kiu/flame/README

flame m0dul

kiu@gmx.net
GPL/CC-BY-3.0
https://github.com/kiu/flame
