kiu/flame/hardware/pcb/flame-rev-a-gerber.pdf

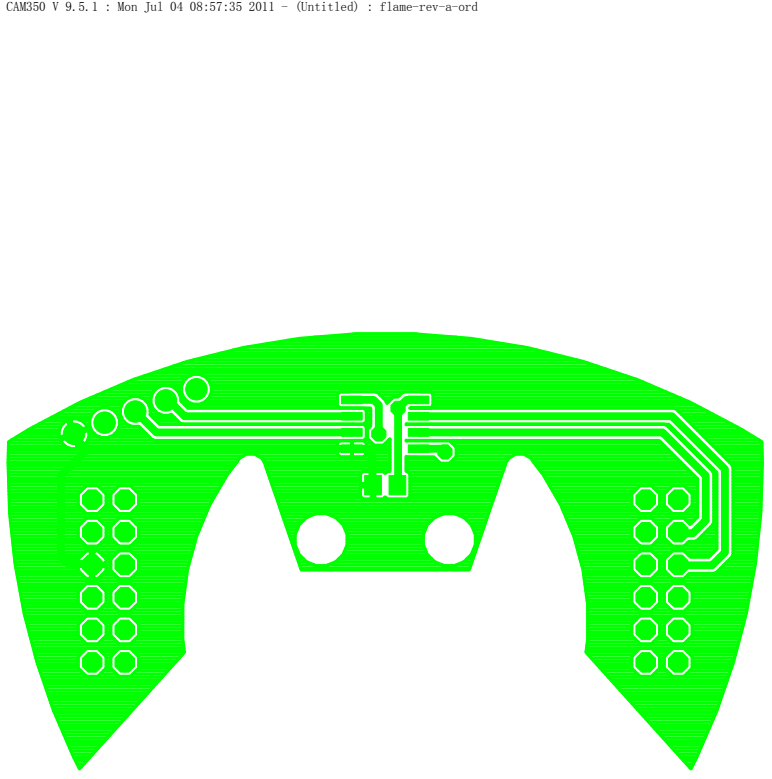
[picture p3: page 1]

CAM350 V 9.5.1 : Mon Jul 04 08:57:35 2011 - (Untitled) : flame-rev-a-ord

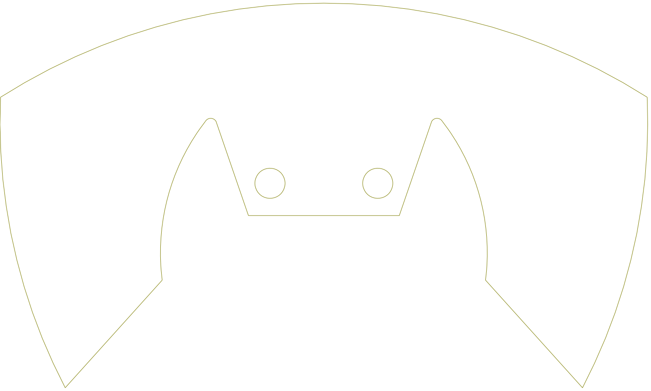
[picture p4: figure]

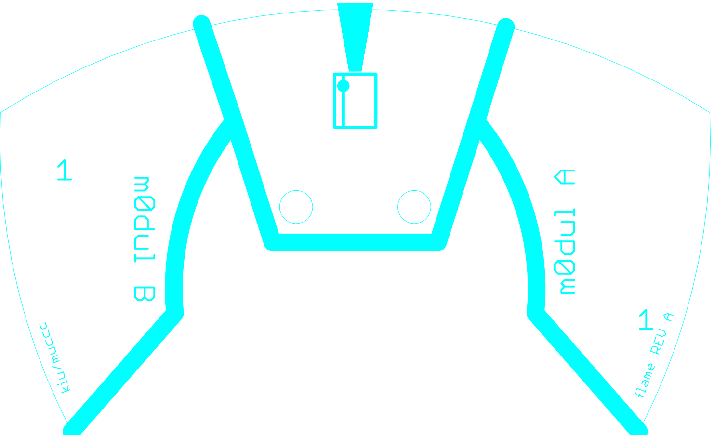
[picture p5: figure]
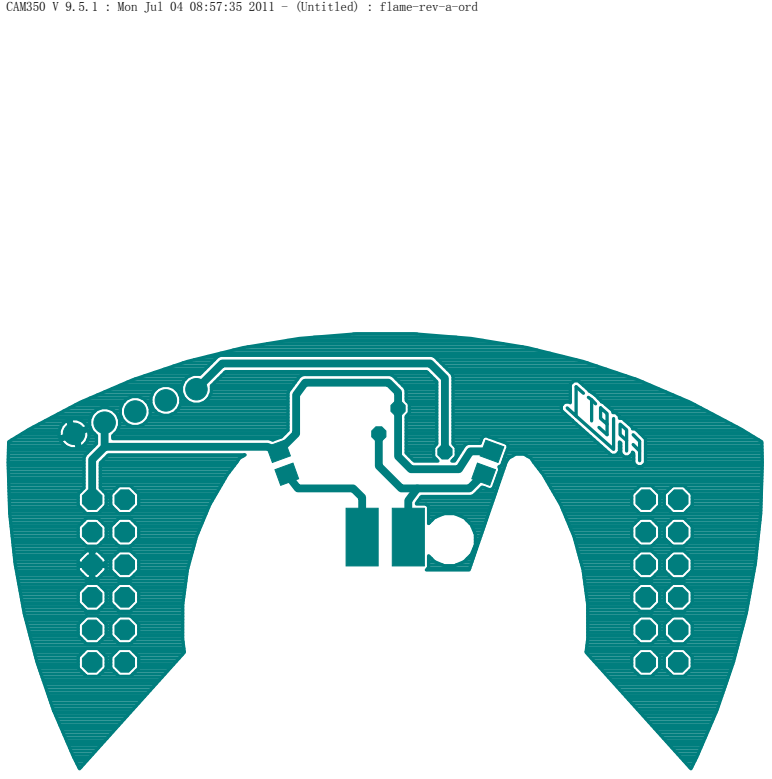
[picture p6: page 4]

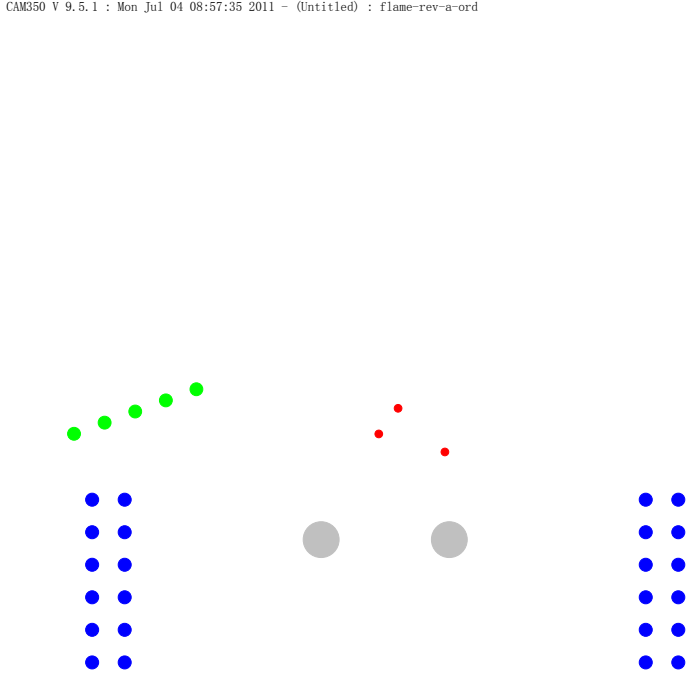
[picture p7: page 7]
