kiu/flame/hardware/pcb/flame-rev-a-brd-bottom.png

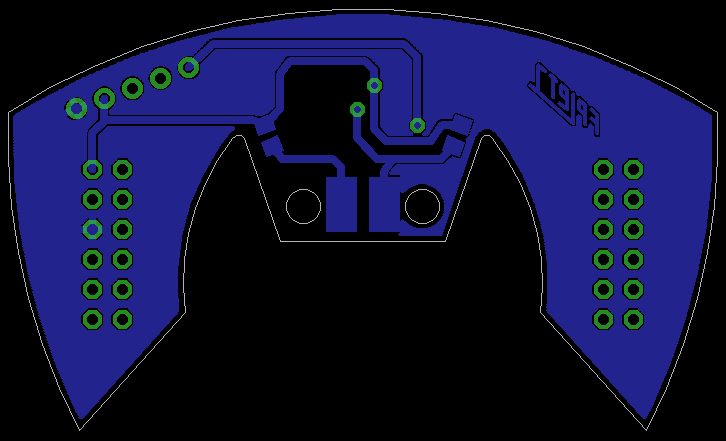
hardware/pcb/flame-rev-a-brd-bottom.png
