kiu/flame/hardware/pcb/flame-rev-a-brd-top.png

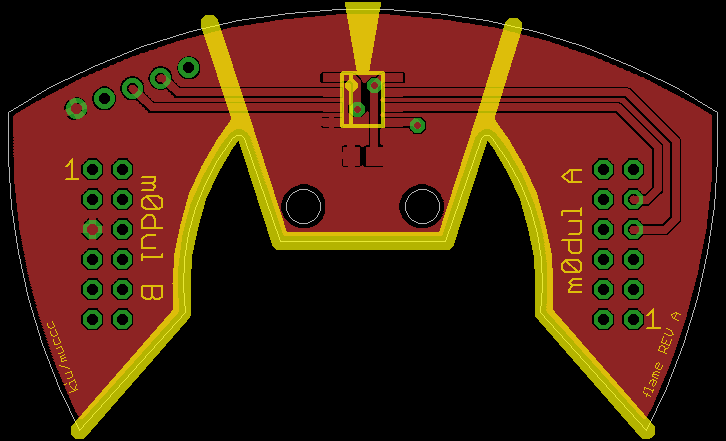
hardware/pcb/flame-rev-a-brd-top.png
