kiu/flame/hardware/pcb/flame-rev-a-sch.png

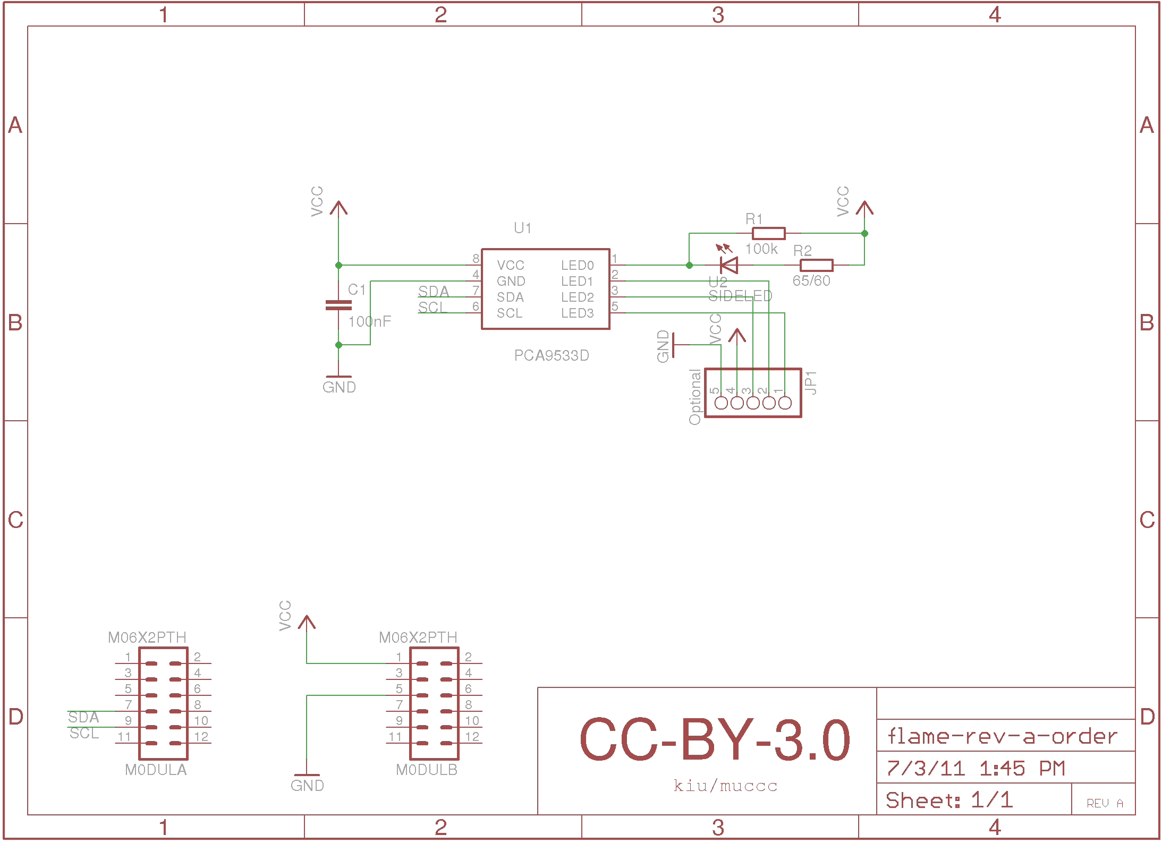
hardware/pcb/flame-rev-a-sch.png
