kiu/flame/doc/flame_bom.ods

Ordered | Description | Qty | Price | Price (sum) | Id | Link
X | 100 scews DIN 7985 A2 M2,5X10 | 2 | 4.99 € | 9.98 € |  | http://www.screwsandmore.de/product_info.php?cPath=880_882_951_973&products_id=1579
X | 25 screws DIN 7985 A2 M2,5X10 | 1 | 1.49 € | 1.49 € |  | http://www.screwsandmore.de/product_info.php?cPath=880_882_951_973&products_id=1577
X | 100 nuts DIN 934 A2 M2,5 | 2 | 3.69 € | 7.38 € |  | http://www.screwsandmore.de/product_info.php?cPath=184_185_192&products_id=438
X | 25 nuts DIN 934 A2 M2,5 | 1 | 1.19 € | 1.19 € |  | http://www.screwsandmore.de/product_info.php?cPath=184_185_192&products_id=436
X | Shipping screws and more | 1 | 4.50 € | 4.50 € |  | http://www.screwsandmore.de
X | Plexiglas XT 600x300x4 | 2 | 10.40 € | 20.80 € |  | http://myworld.ebay.de/plexiglas-international/?_trksid=p4340.l2559
X | Shipping plexiglas | 1 | 4.90 € | 4.90 €
- | Laser | 1 | 50.00 € | 50.00 € |  | http://www.fablab-muenchen.de/
- | Printouts | 1 | 5.00 € | 5.00 € |  | http://www.repacopy.at/index.php?id=527
X | PCBs (100 pcs, 60x36, black, 1xsilk) | 1 | 142.00 € | 142.00 € |  | http://www.pcbcart.com
X | 115 Druckverschlussbeutel. 160X220mm | 1 | 4.50 € | 4.50 € |  | http://cgi.ebay.de/ws/eBayISAPI.dll?ViewItem&item=360231230518
X | LED yellow | 24 | 0.23 € | 5.60 € | 475-2787-1-ND | http://search.digikey.com/scripts/DkSearch/dksus.dll?Detail&name=475-2787-1-ND
X | LED amber | 24 | 0.23 € | 5.60 € | 475-2695-1-ND | http://search.digikey.com/scripts/DkSearch/dksus.dll?Detail&name=475-2695-1-ND
X | LED orange | 24 | 0.28 € | 6.74 € | 475-2737-1-ND | http://search.digikey.com/scripts/DkSearch/dksus.dll?Detail&name=475-2737-1-ND
X | LED red | 44 | 0.33 € | 14.71 € | 475-2503-1-ND | http://search.digikey.com/scripts/DkSearch/dksus.dll?Detail&name=475-2503-1-ND
X | R1: 65 (led) | 150 | 0.01 € | 1.70 € | 311-64.9CRCT-ND | http://search.digikey.com/scripts/DkSearch/dksus.dll?Detail&name=311-64.9CRCT-ND
X | R1: 60 (led red) | 110 | 0.01 € | 1.24 € | 311-60.4CRCT-ND | http://search.digikey.com/scripts/DkSearch/dksus.dll?Detail&name=311-60.4CRCT-ND
X | R2: 100k (reduce idle) | 250 | 0.01 € | 1.64 € | 311-100KARCT-ND | http://search.digikey.com/scripts/DkSearch/dksus.dll?Detail&name=311-100KARCT-ND
X | C1: 100nF (ic) | 230 | 0.02 € | 4.84 € | 311-1361-1-ND | http://search.digikey.com/scripts/DkSearch/dksus.dll?Detail&name=311-1361-1-ND
X | Shipping digikey <65€ | 1 | 21.42 € | 21.42 € |  | http://www.digikey.de
X | PCA9533 (SO8) | 106 | 0.86 € | 90.69 € | 771-PCA9533D01118 | Http://www.mouser.com
X | Shipping mouser <75€ | 0 | 20.00 € | 0.00 € |  | Http://www.mouser.com
- | 2x06 stackthrough | 200 | 0.24 € | 48.00 € |  | internal bulk order
 |  |  |  | SUM | per m0dul
 |  |  |  | 453.93 € | 4.54 €
 | Alternatives:
 | PCA9530 (SO8) | 105 | 1.18 € | 124.21 € | 568-1830-1-ND | http://search.digikey.com/scripts/DkSearch/dksus.dll?Detail&name=568-1830-1-ND
 | PCA9550 (SO8) | 105 | 0.88 € | 92.46 € | 771-PCA9550D-T | Http://www.mouser.com
 | PCA9633 (SO16) | 105 | 0.61 € | 63.97 € | 771-PCA9633D16-T | Http://www.mouser.com
