kiu/flame/(commit log)

2011-07-17 added LED types
2011-07-17 added PCB
    [flame-rev-a.brd, flame-rev-a.sch, flame-rev-b.brd, flame-rev-b.sch]
2011-07-17 renamed dir
    [flame-rev-a.brd, flame-rev-a.sch, flame-rev-b.brd, flame-rev-b.sch]
2011-07-17 added BOM
    [flame_bom.ods]
2011-07-23 corrected price for stack through connectors
    [flame_bom.ods]
2011-07-31 updated stack through connector
    [flame_bom.ods]
